cycfi/connect/README.md

# connect
Peripherals for connecting and controlling musical instruments
