cycfi/connect/e_whammy/spice/ewhammy_final_simulation_summary.docx

# eWhammy Center Stability: Current Final Simulation Summary

Current design as of May 17, 2026. The earlier differentiator/integrator report has been preserved as ewhammy_diff_integrator_historical_simulation_summary.docx for historical context.

# Executive Summary

The current design is a windowed servo architecture with a narrow moving center window, a startup reset that forces HOLD low during power-up, and a deliberately limited pitch range of +/-12 semitones. The smaller musical range makes one semitone large enough to escape the reset window, while the moving window still captures mechanical return offsets after large bends.

The latest simulation, plot14.csv, shows the intended behavior: the +/-1 semitone holds are outside the window with HOLD asserted, releases return inside the window, and vibrato remains largely expressive because the reset dynamics are slow relative to the vibrato frequency.

# Historical Context

The renamed historical document records the previous line of investigation: deadband behavior, high-pass bypasses, always-on correction, and a differentiator/integrator signal path with conditional bleed. The present design keeps the servo/HOLD idea and solves the release asymmetry with a moving window center instead of a wider fixed window.

Document | Role
ewhammy_diff_integrator_historical_simulation_summary.docx | Historical summary of the differentiator/integrator exploration.
ewhammy_final_simulation_summary.docx | Current final summary for the moving-window servo design.

# Problem And Scaling

The raw Hall sensor model includes spring-steel hysteresis at release. The natural center is 2.1750 V in the raw sensor domain. After an upward release the model returns to 2.1825 V; after a downward release it returns to 2.1675 V. That 15 mV sensor-domain separation becomes about 150 mV at OUT because of the high-gain output path.

The pitch range is now intentionally limited to +/-12 semitones. With a 5 V output span, one semitone is 208.33 mV at OUT, or 20.8333 mV in the raw SENSOR domain. This keeps a one-semitone musical hold clearly outside the roughly +/-94 mV reset window.

Quantity | Value | Meaning
Output pitch range | +/-12 semitones | 24 semitones across 5 V
One semitone at OUT | 208.33 mV | Large enough to escape the reset window
One semitone at SENSOR | 20.8333 mV | Used by the inserted semitone tests
Moving-window half-width | 94.226 mV mean | About 45 cents under the +/-12 semitone mapping
Spring release separation | 15 mV at SENSOR | About 150 mV at OUT

# Startup Movement Stress Test

The initial triangular-looking motion near the beginning of the plot is intentional. It is not a power-on artifact. The SENSOR model deliberately exercises motion while the startup reset is active: 0.00-0.20 s ramps from 0 V to the 2.175 V baseline; 0.20-0.35 s holds baseline; 0.35-0.45 s ramps up to 2.275 V; 0.45-0.55 s ramps down to 2.025 V; and 0.55-0.65 s returns to 2.175 V.

This startup movement test verifies that the forced-reset/acquisition interval does not leave the servo in a bad state when the player moves the bar immediately after power-up. The circuit should settle back near center before the later large-bend and semitone-hold tests begin.

# Current Architecture

The circuit uses HOLD to decide when the servo correction path may track. HOLD is asserted outside the accepted center region and released inside it. A startup reset circuit forces HOLD low during power-up so the servo can acquire center before normal motion begins.

The discriminator window has a moving center. WH and WL retain a narrow fixed separation, while their midpoint follows a low-pass filtered version of OUT. Slow return offsets are therefore accepted without permanently widening the near-center reset window.

Block | Current value / behavior | Purpose
Servo input weighting | R1 = 47k, R2 = 47k | Combines SENSOR and OFFS into the servo-controlled signal path.
Output gain/reference network | R3 = 190k, R4 = 10k | Implements the high gain around VREF used by the OUT stage.
Integrator and leak | R9 = 100k, C1 = 10uF; leak T-network R10 = 100k, R13 = 100k, R18 = 499R | Stores OFFS while providing about 20.24 Mohm effective leakage, roughly doubling the earlier leak time.
Window base divider | R5 = 120k, R7 = 10k, R8 = 120k | Defines the narrow window width around the moving center.
Moving-center injection | R6 = 4.7k, R15 = 4.7k, R16 = 250k, C4 = 2.2uF | Low-pass filters OUT and shifts WH/WL together.
Startup reset | U7 open-drain inverter, C2 = 2.2uF, R12 = 1M | Forces HOLD low at startup for roughly 1.5 s.
Supply simulation | +5V and VREF pulses use tw=20, per=40 | Keeps rails active through the 11 s transient run.

# Latest Simulation Evidence

plot14.csv includes WH, WL, HOLD, OUT, and SENSOR. The moving-window half-width is stable: min 94.225 mV, max 94.230 mV, mean 94.226 mV. The moving center ranges from 2.138 V to 2.859 V over the full test.

Event | Time | SENSOR | OUT | Window | HOLD | Result
Startup reset, before acquisition | 0.4997 s | 2.15073 V | 1.96018 V | 2.41731 to 2.60576 V | 0.00 V | outside
Startup settled | 1.5006 s | 2.17500 V | 2.49849 V | 2.40596 to 2.59442 V | 0.00 V | inside
Large upward bend held | 2.2507 s | 2.42500 V | 4.98939 V | 2.58087 to 2.76932 V | 5.00 V | outside
Upward release near center | 3.4997 s | 2.18250 V | 2.50171 V | 2.44883 to 2.63729 V | 0.01 V | inside
Downward bend held | 4.5005 s | 1.92551 V | -0.00452 V | 2.04349 to 2.23194 V | 5.00 V | outside
Downward release captured | 4.7509 s | 2.16750 V | 2.36174 V | 2.20355 to 2.39200 V | 0.00 V | inside
Pre-semitone center | 5.4009 s | 2.16769 V | 2.49999 V | 2.40089 to 2.58934 V | 0.01 V | inside
+1 semitone hold | 5.8995 s | 2.18833 V | 2.67237 V | 2.42916 to 2.61761 V | 5.00 V | outside
+1 release recovered | 6.6799 s | 2.16750 V | 2.49503 V | 2.40703 to 2.59548 V | 0.00 V | inside
Center gap | 7.3999 s | 2.16750 V | 2.49836 V | 2.40555 to 2.59400 V | 0.00 V | inside
-1 semitone hold | 7.9000 s | 2.14667 V | 2.31067 V | 2.38041 to 2.56886 V | 5.00 V | outside
-1 release recovered | 8.5599 s | 2.16750 V | 2.50489 V | 2.39925 to 2.58771 V | 0.01 V | inside
Vibrato sample | 9.7990 s | 2.16720 V | 2.47522 V | 2.39901 to 2.58747 V | 0.01 V | inside
End of run | 11.0000 s | 2.16750 V | 2.49830 V | 2.40519 to 2.59365 V | 0.00 V | inside

The +1 semitone hold is outside the window for 400 of 400 samples, with OUT ranging from 2.66588 V to 2.67885 V. The -1 semitone hold is outside for 401 of 401 samples, with OUT ranging from 2.30407 V to 2.31729 V.

Leak drift during the 800 ms semitone holds is now about -12.0 mV on the upward hold and -13.2 mV on the downward hold, roughly 6 cents at the +/-12 semitone scaling.

Release artifact | Peak error | To +/-10 mV | To +/-5 mV | To +/-2 mV | To +/-1 mV
+1 release undershoot | -55.4 mV | 188 ms | 280 ms | 502 ms | not reached
-1 release overshoot | +30.1 mV | 104 ms | 160 ms | 220 ms | 252 ms

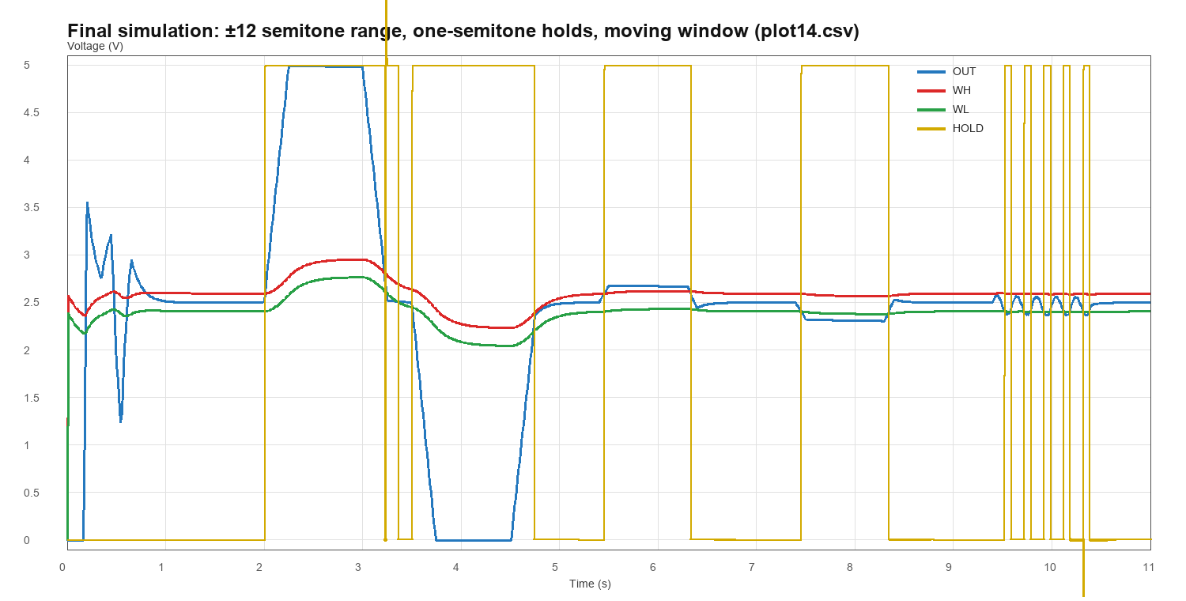
[picture p1: figure]

Figure 1. Final simulation overview from plot14.csv. OUT is blue, WH red, WL green, and HOLD yellow. The one-semitone holds escape the moving reset window; releases return inside the window.

# Vibrato And Hold Behavior

During the 5 Hz vibrato interval, OUT ranges from 2.36286 V to 2.57451 V. Some samples leave the window (142 of 515), but this is acceptable because the reset/integrator dynamics are slow relative to vibrato and do not clamp the expressive motion.

The release overshoot is short and sign-symmetric. The upward hold release undershoots by about 55 mV and is within 5 mV after about 280 ms; the downward hold release overshoots by about 30 mV and is within 5 mV after about 160 ms. In normal playing, held notes are likely to include vibrato, so these settling artifacts should be masked further.

# Current Conclusion

The current design is a workable compromise: the +/-12 semitone range makes intentional one-semitone holds escape the reset mechanism, the moving window captures return-to-center behavior after large bends, the startup reset avoids initial saturation/state errors, and the longer leak time reduces held-note drift without adding release-detect logic.

# Open Checks Before Hardware Freeze

- Validate the moving-window low-pass timing with real playing gestures.
- Confirm MLCC effective capacitance for the 2.2uF and 10uF parts at actual bias.
- Check comparator/open-drain pull-up values and propagation around HOLD transitions.
- Measure real spring hysteresis distribution across assembled hardware.
- Listen specifically for held-note drift and release settling with vibrato applied.

eWhammy current final simulation summary - May 17, 2026
