cycfi/connect/e_whammy/e_whammy.step

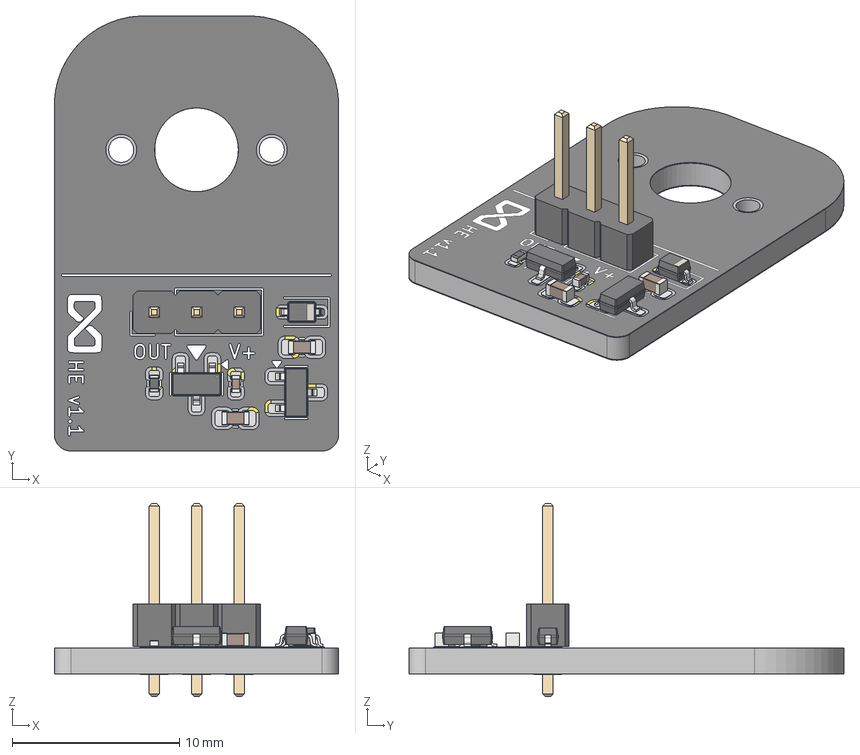
[picture p5: CAD file, 2026-02-02]
e_whammy/e_whammy.step
17.0 x 26.0 x 11.5 mm
PinHeader_1x03_P2.54mm_Vertical
C_0603_1608Metric x 2
R_0402_1005Metric
D_SOD-323
SOT-23 x 2
C_0402_1005Metric
e_whammy_hal_sensor_copper
e_whammy_hal_sensor_pad
e_whammy_hal_sensor_silkscreen
e_whammy_hal_sensor_soldermask
e_whammy_hal_sensor_PCB
