cycfi/connect/e_whammy/e-whammy-pcb.DXF

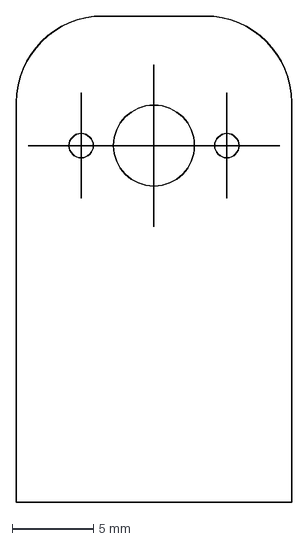
[picture p6: CAD file, 2025-07-18]
e_whammy/e-whammy-pcb.DXF
17.0 x 30.0 mm
