cycfi/connect/e_whammy/spring-plate.DXF

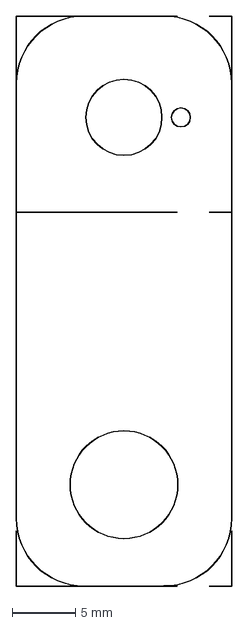
[picture p7: CAD file, 2025-04-13]
e_whammy/spring-plate.DXF
17.0 x 45.0 mm
