cycfi/connect/(commit log)

2022-02-27 First commit: 5-way switch
    [5way_Switch_board.kicad_pcb, 5way_Switch_board.kicad_sch, 5way_Switch_board.sch]
2022-02-27 added label
    [5way_Switch_board.kicad_sch]
2022-02-27 More updates. I think we're good.
    [5way_Switch_board.kicad_pcb, 5way_Switch_board.kicad_sch]
2022-02-27 not needed
    [5way_Switch_board.sch]
2022-02-27 version update
    [5way_Switch_board.kicad_sch]
2022-02-27 Added bllank 5way CV module
    [5way_cv_module.kicad_pcb, 5way_cv_module.kicad_sch]
2022-02-27 this is where the pcb library paths are stored
2022-02-28 moved the connector closer to the edge
    [5way_Switch_board.kicad_pcb]
2022-02-28 added opamp buffer better layout
    [5way_cv_module.kicad_pcb, 5way_cv_module.kicad_sch]
2022-02-28 added logo
    [5way_cv_module.kicad_pcb]
2022-03-01 Added dedicated 5-way CV switch
    [5way_cv_switch.kicad_pcb, 5way_cv_switch.kicad_sch]
2022-03-01 minor updates
    [5way_cv_switch.kicad_pcb, 5way_cv_switch.kicad_sch]
2022-03-01 Added small CV Pot
    [5way_cv_switch.kicad_sch, cv_pot_small.kicad_pcb, cv_pot_small.kicad_sch]
2022-04-16 Updated components for JLCPCB PCBA
    [5way_cv_switch.kicad_pcb, 5way_cv_switch.kicad_sch, cv_pot_small.kicad_pcb, cv_pot_small.kicad_sch]
2022-04-18 PCB fabrication
2022-04-20 Big CV pot
    [cv_pot_big.kicad_pcb, cv_pot_big.kicad_sch]
2022-04-20 Added big CV pot
    [cv_pot_big_panel.kicad_pcb, cv_pot_small.kicad_sch]
2022-06-07 Added diode markings in the silkscreen
    [5way_cv_switch.kicad_pcb, cv_pot_small.kicad_pcb]
2022-06-09 Updates: - Fixed overlapping fill regions when paneling - Added JLCPCB rotation
    [5way_cv_switch.kicad_pcb, 5way_cv_switch.kicad_sch]
2022-06-20 Switched to TLV6001UIDBVR Opamp
    [cv_pot_big.kicad_pcb, cv_pot_big.kicad_sch, cv_pot_small.kicad_pcb, cv_pot_small.kicad_sch]
2022-06-21 Added CV buffer
    [cv_buffer.kicad_pcb, cv_buffer.kicad_sch]
2022-06-21 Added concentric pot board
    [concentric_pot.kicad_pcb, concentric_pot.kicad_sch]
2022-06-23 - added tapering resistor - added fabrication script
    [cv_buffer.kicad_pcb, cv_buffer.kicad_sch]
2022-06-23 - added fabrication script
    [concentric_pot.kicad_pcb, concentric_pot.kicad_sch]
2022-06-23 Added single (big) pot
    [single_pot.kicad_pcb, single_pot.kicad_sch]
2023-01-22 Added CV Slider
    [cv_slider.kicad_pcb, cv_slider.kicad_sch]
2023-01-22 Added fab and updates
    [concentric_pot.kicad_pcb]
2023-08-05 Added taper resistor
    [concentric_pot.kicad_pcb, concentric_pot.kicad_sch]
2023-08-05 Removed taper resistor
    [cv_buffer.kicad_pcb, cv_buffer.kicad_sch]
2023-08-05 Changed taper resistor value
    [cv_pot_small.kicad_pcb, cv_pot_small.kicad_sch]
2023-08-05 Added LCSC part
    [cv_slider.kicad_sch]
2023-08-16 Update to v3.1
    [single_pot.kicad_pcb, single_pot.kicad_sch]
2023-08-16 Added rotation correction for JLCPCB
    [cv_buffer.kicad_sch]
2024-08-06 Added 1k output resistor
    [cv_pot_big.kicad_pcb, cv_pot_big.kicad_sch, cv_pot_small.kicad_pcb, cv_pot_small.kicad_sch, cv_slider.kicad_pcb, cv_slider.kicad_sch]
2024-08-07 Touch pad initial commit
    [touch_pad.kicad_pcb, touch_pad.kicad_sch]
2024-08-08 Minor tweaks
    [touch_pad.kicad_pcb, touch_pad.kicad_sch]
2024-09-26 Place components away from board edge
    [touch_pad.kicad_pcb]
2024-09-27 Fabricating cv-slider prototype
    [cv_slider.kicad_pcb, cv_slider.kicad_sch]
2024-09-27 fabricating the touch_pad prototype
    [touch_pad.kicad_sch]
2024-11-02 Bump date
    [touch_pad.kicad_sch]
2024-11-02 PCB manufacturing adjustments
    [cv_slider.kicad_pcb, cv_slider.kicad_sch]
2024-11-02 First shot e-whammy
    [e_whammy.kicad_pcb, e_whammy.kicad_sch]
2024-11-02 Added kikit fab script
    [e_whammy.kicad_sch]
2024-11-14 Changed to non-inverting configuration
    [e_whammy.kicad_pcb, e_whammy.kicad_sch]
2024-11-14 Adjusted values for component availability
    [e_whammy.kicad_pcb, e_whammy.kicad_sch]
2025-04-13 New uni-mount version
    [e_whammy.kicad_pcb, e_whammy.kicad_sch, spring-plate.DXF]
2025-07-17 pcb_common updates
2025-07-18 Separating the HE sensor from CV conditioning
    [e-whammy-pcb.DXF, e_whammy_hal_sensor.kicad_pcb, e_whammy_hal_sensor.kicad_sch]
2025-08-01 Separate the HAL sensor from CV conditioning
    [e_whammy_hal_sensor.kicad_pcb, e_whammy_hal_sensor.kicad_sch]
2025-08-01 Separate control and sensor
    [e_whammy_control.kicad_pcb, e_whammy_control.kicad_sch, e_whammy_hal_sensor.kicad_pcb]
2025-08-02 - Awesome stuff - Added DC Servo center correction - Added deadband null (thanks to Béla Becker (DECAFBAD on the Discord forum))
    [e_whammy_control.kicad_sch]
2025-08-02 Auto drift compensaion does not work well
    [e_whammy_control.kicad_sch]
2025-08-03 First shot at layout
    [e_whammy_control.kicad_pcb]
2025-08-03 E-Whammy layout complete (first shot)
    [e_whammy_control.kicad_pcb]
2025-08-03 E-Whammy layout looking good!
    [e_whammy_control.kicad_pcb]
2025-08-03 Added bridged jumper pads for overriding the pots
    [e_whammy_control.kicad_pcb, e_whammy_control.kicad_sch]
2025-08-03 More refinements
    [e_whammy_control.kicad_pcb, e_whammy_control.kicad_sch]
2025-08-03 Updated circuit matching the E-Whammy control design.
    [e_whammy_control.kicad_pcb, e_whammy_hal_sensor.kicad_pcb, e_whammy_hal_sensor.kicad_sch]
2025-08-03 Recover lost refinements
    [e_whammy_control.kicad_pcb]
2025-08-04 Removing the old e-whammy single PCB, replacing it with separate sensor and CV conditioning
    [e_whammy.kicad_pcb, e_whammy.kicad_sch]
2025-08-05 Finishing touches
    [e_whammy_control.kicad_pcb, e_whammy_control.kicad_sch]
2025-08-05 Tighter tolerance
    [e_whammy_hal_sensor.kicad_pcb]
2025-08-21 E-Whammy update: bug fixes and refinements
    [e_whammy_control.kicad_pcb, e_whammy_control.kicad_sch, e_whammy_hal_sensor.kicad_pcb, e_whammy_hal_sensor.kicad_sch]
2025-08-21 Ported 2-Way switch to KiCAD. Bumped version to 2.6.
    [mom_2way.kicad_pcb, mom_2way.kicad_sch]
2025-08-21 2-Way Switch refinements
    [mom_2way.kicad_pcb, mom_2way.kicad_sch]
2025-08-22 Cleanup and refinements
    [mom_2way.kicad_pcb, mom_2way.kicad_sch]
2025-09-14 The alignment holes are missing!
    [e_whammy_hal_sensor.kicad_pcb]
2025-10-30 Updated 1-3-2 pinout
    [e_whammy_control.kicad_pcb, e_whammy_control.kicad_sch, e_whammy_hal_sensor.kicad_pcb]
2026-02-02 - Step file generated - Fab files
    [e_whammy.step, e_whammy_hal_sensor.kicad_pcb]
2026-02-02 kicad_pro updated
2026-02-02 pcb-commmon upodated
2026-02-08 Big pot update: the header now points towards the terminals side
    [cv_pot_big.kicad_pcb, cv_pot_big.kicad_sch]
2026-02-08 PCB common updates
2026-02-15 Added audio_buffer (imported and refined from the Nu project).
    [audio_buffer.kicad_pcb, audio_buffer.kicad_sch]
2026-02-15 Update with log and exp taper
    [cv_pot_big.kicad_pcb, cv_pot_big.kicad_sch]
2026-02-15 Update v1.1 - Added EXP and LOG taper shunts
    [cv_slider.kicad_pcb, cv_slider.kicad_sch]
2026-02-15 Change symbol to generic one
    [cv_pot_big.kicad_sch]
2026-02-15 Switch to triangular solder shunt
    [audio_buffer.kicad_pcb, audio_buffer.kicad_sch]
2026-02-15 CV buffer updates to v3.1 PCB re-layout + various schematic refinements
    [cv_buffer.kicad_pcb, cv_buffer.kicad_sch]
2026-02-15 pcb_common submodule update
2026-02-16 Adjusted the slider pad's hole diameter to 1mm
    [cv_slider.kicad_pcb]
2026-03-05 Added signal shunt with HP filter (DC blocking) to allow fine vibrato within the deadband.
    [e_whammy_control.kicad_pcb, e_whammy_control.kicad_sch]
2026-03-09 - Added a precision voltage reference for VREF - Removed deadband bypass
    [e_whammy_control.kicad_pcb, e_whammy_control.kicad_sch]
2026-04-15 Added Opamp bypass cap
    [cv_pot_big.kicad_pcb, cv_pot_big.kicad_sch]
2026-04-15 Added buffered audio pot
    [audio_pot_big.kicad_pcb, audio_pot_big.kicad_sch]
2026-04-16 Big audio pot update + fab
    [audio_pot_big.kicad_sch]
2026-04-16 Schematics minor updates (net naming)
    [audio_pot_big.kicad_pcb, audio_pot_big.kicad_sch]
2026-04-24 - Fab updates - Added SMD 2x3P header
    [audio_pot_big.kicad_pcb, audio_pot_big.kicad_sch]
2026-04-24 - CV pot big updates for Fab - Added SMD 1x3P header
    [cv_pot_big.kicad_sch]
2026-04-27 Added spice simulations for v2
    [e_whammy_control_v2_sim.kicad_sch, e_whammy_control_v2b.kicad_sch]
2026-04-30 Added output 1k resistor
    [cv_buffer.kicad_pcb, cv_buffer.kicad_sch]
2026-05-03 New v2 eWhammy control scheme using differentiator and switched auto-centering integrator
    [e_whammy_control.kicad_pcb, e_whammy_control.kicad_sch]
2026-05-04 - Center the outline - Adjust width to 10 mm (min. JLCPCB allowed)
    [e_whammy_control.kicad_pcb]
2026-05-04 (ewhammy v2) - Component fixes - Added test points
    [e_whammy_control.kicad_pcb, e_whammy_control.kicad_sch]
2026-05-05 Change voltage reference to a more common type TI REF3025AIDBZR
    [e_whammy_control.kicad_pcb, e_whammy_control.kicad_sch]
2026-05-06 Fix wrong value displayed
    [e_whammy_control.kicad_sch]
2026-05-06 Added for presentation only
    [diff-integ.kicad_sch]
2026-05-12 Added startup reset
    [e_whammy_control_v2b.kicad_sch]
2026-05-16 Updated DC servo schematic for spice simulation
    [e_whammy_control.kicad_pcb, e_whammy_control.kicad_sch, e_whammy_control_v2_sim.kicad_sch, e_whammy_control_v2b.kicad_sch, e_whammy_hal_sensor.kicad_pcb]
2026-05-17 Not quite working. WIP. the OUT is falling outside the window
    [e_whammy_control_v2_sim.kicad_sch]
2026-05-17 Document current e-whammy reset simulation
    [e_whammy_control_v2_sim.kicad_sch]
2026-05-17 Tune e-whammy semitone hold simulation
    [e_whammy_control_v2_sim.kicad_sch]
2026-05-17 Update e-whammy final simulation notes
    [e_whammy_control_v2_sim.kicad_sch]
2026-05-18 - Cleanup - Simplification
    [e_whammy_control_v2_sim.kicad_sch]
2026-05-26 Updates using DC servo mechanism
    [e_whammy_control.kicad_pcb, e_whammy_control.kicad_sch, e_whammy_control_v2_sim.kicad_sch]
2026-05-27 Add 3D model for the slider
    [cv_slider.kicad_pcb, cv_slider.kicad_sch]
2026-06-22 e-Whammy v2 sim: model Q1 as 2N7002 startup gate
    Replace Q1's bare default VDMOS with the named 2N7002 library model
    (Vgs(th) ~2.1 V). The old default only acquired startup because ngspice's
    default VDMOS happens to sit near VCC/2; a realistic logic-level FET breaks it.
    Q1 is the non-critical startup-reset switch (out of the signal path), so only
    the threshold matters. Sim still reproduces plot14; startup acquires ~1.02 s.
    Bumps pcb_common for the 2N7002 model.
    [e_whammy_control_v2_sim.kicad_sch]
2026-06-22 schematics cleanup
    [e_whammy_control.kicad_sch, e_whammy_hal_sensor.kicad_sch]
2026-06-23 e-Whammy: add latch-up recovery to v2_sim (RESET = WINDOW OR STARTUP OR TIMEOUT)
    Replaces Q1/R9/C2/R10/C3 startup-gate path with a 4-gate Schmitt-NAND
    recovery: startup ramp + window comparators + asymmetric timeout envelope.
    Bumps pcb_common for the SCHMITT_NAND symbol and cycfi_schmitt_nand subckt.
    [e_whammy_control_v2_sim.kicad_sch]
2026-06-23 e-Whammy: simplify latch recovery to 2 gates (NAND+NOR, active-low RESET)
    Replaces the 4-NAND RESET=WINDOW OR STARTUP OR TIMEOUT with U6=NAND(startup,
    timeout) -> U7=NOR(WINDOW,U6); ADG779 poles reversed so RESET is active-low
    (0=correct, 1=hold). Deletes U7/U8/U9 (old NANDs). Full sim reproduces the
    validated metrics. Bumps pcb_common for the SCHMITT_NOR symbol + subckt.
    [e_whammy_control_v2_sim.kicad_sch]
2026-06-23 e-Whammy: aesthetic layout refinements + Schmitt-glyph symbols (submodule bump)
    [e_whammy_control_v2_sim.kicad_sch]
2026-06-23 e-Whammy: collapse latch recovery to one configurable gate
    RESET = WINDOW ? 0 : CTN = !WINDOW * CTN, realized in a single 2:1 Schmitt
    mux (74x1G97-class). Deletes the startup R-C (R21/C20) and the second gate -
    the timeout cap's power-on discharge supplies the startup force (startup and
    latch-recovery are the same 'not recently inside the window' condition).
    Full sim reproduces the metrics. Bumps pcb_common for cycfi_schmitt_mux.
    [e_whammy_control_v2_sim.kicad_sch]
2026-06-24 e-Whammy: minor layout cleanup of v2_sim (one-gate recovery)
    [e_whammy_control_v2_sim.kicad_sch]
